OscarMurillol/Digital-1.2-2026-1/DivisionBin.jpg

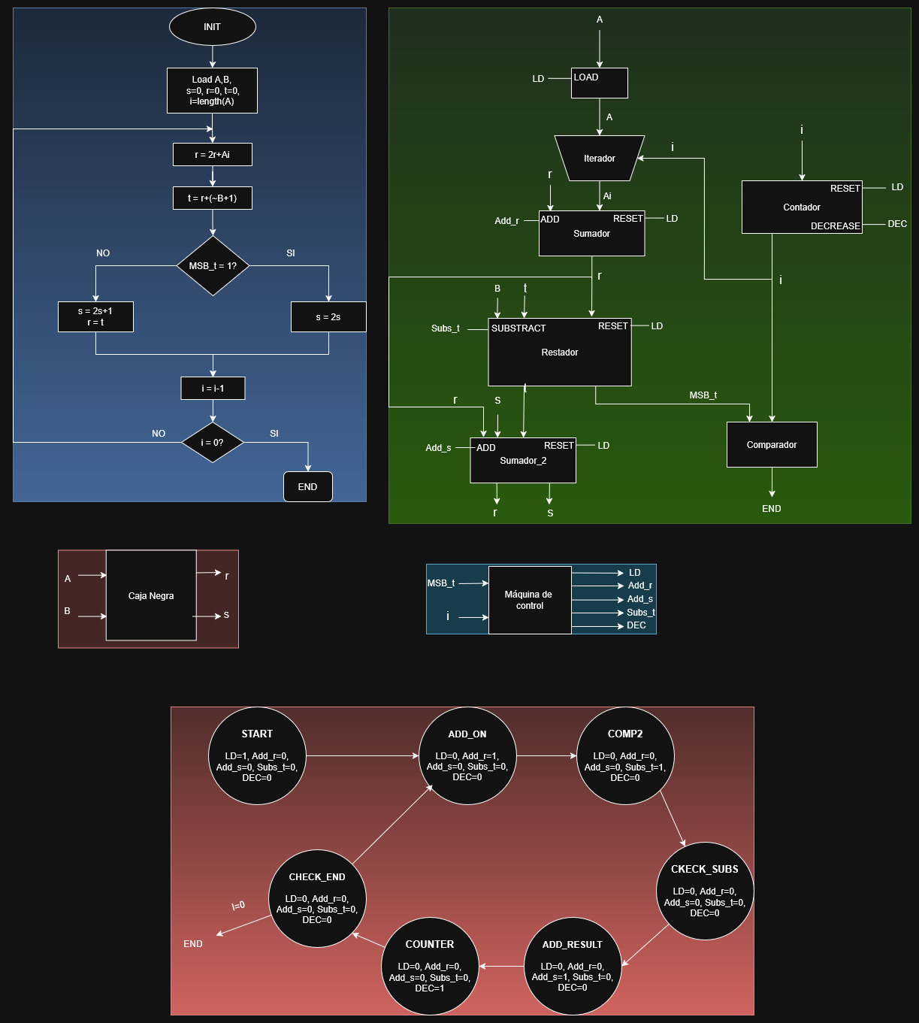
DivisionBin.jpg
