OscarMurillol/Digital-1.2-2026-1/Los Diagramas/DivisionBinCORREGIDO(1).jpg

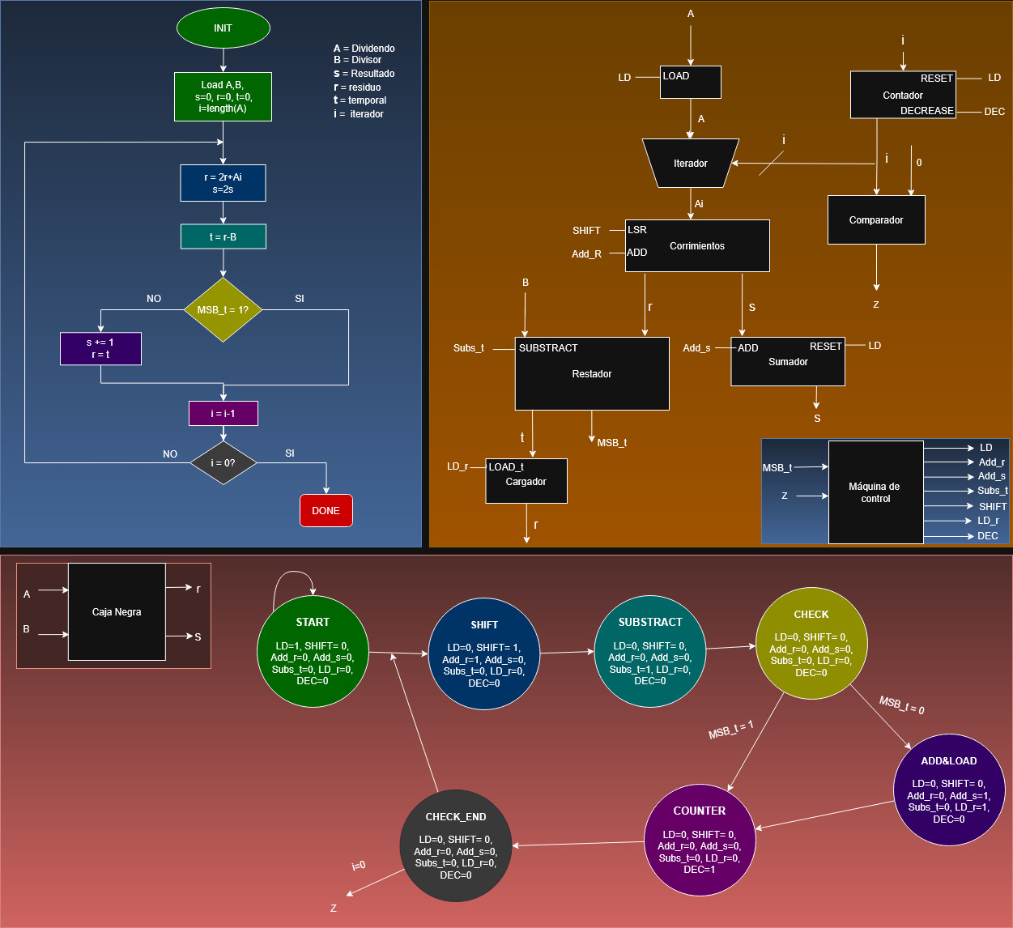
Los Diagramas/DivisionBinCORREGIDO(1).jpg
