OscarMurillol/Digital-1.2-2026-1/CaballodeTroyaEuler/DiagramaGeneral/DiagramaCABALLO.png

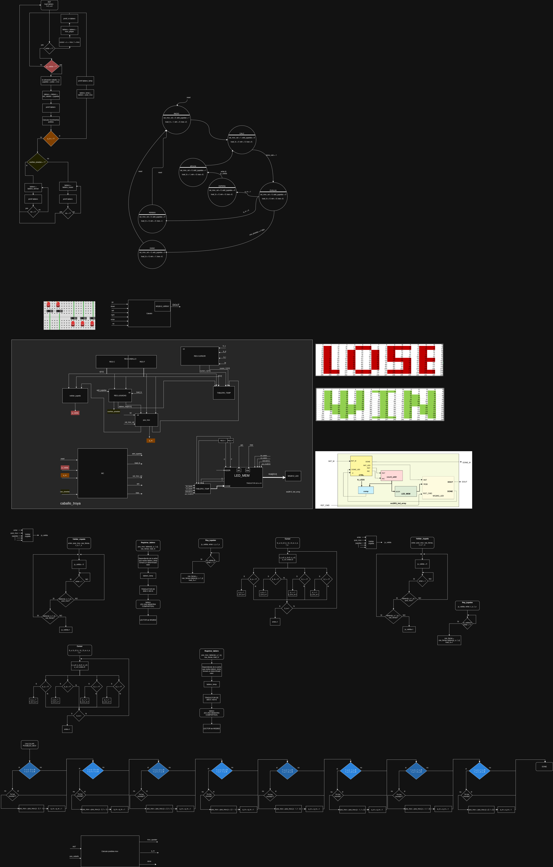
CaballodeTroyaEuler/DiagramaGeneral/DiagramaCABALLO.png
