OscarMurillol/Digital-1.2-2026-1/DFMultBin.jpeg

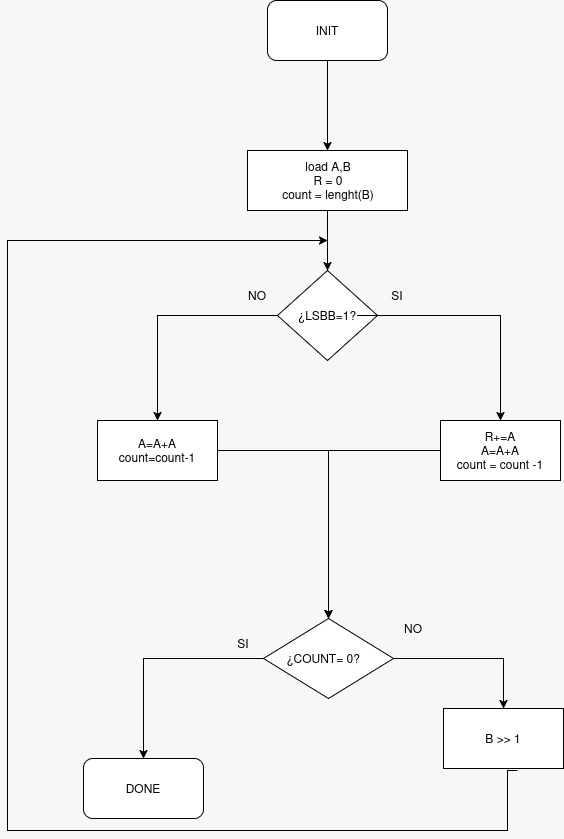
DFMultBin.jpeg
