OscarMurillol/Digital-1.2-2026-1/Los Diagramas/BCDtoBIN.jpg

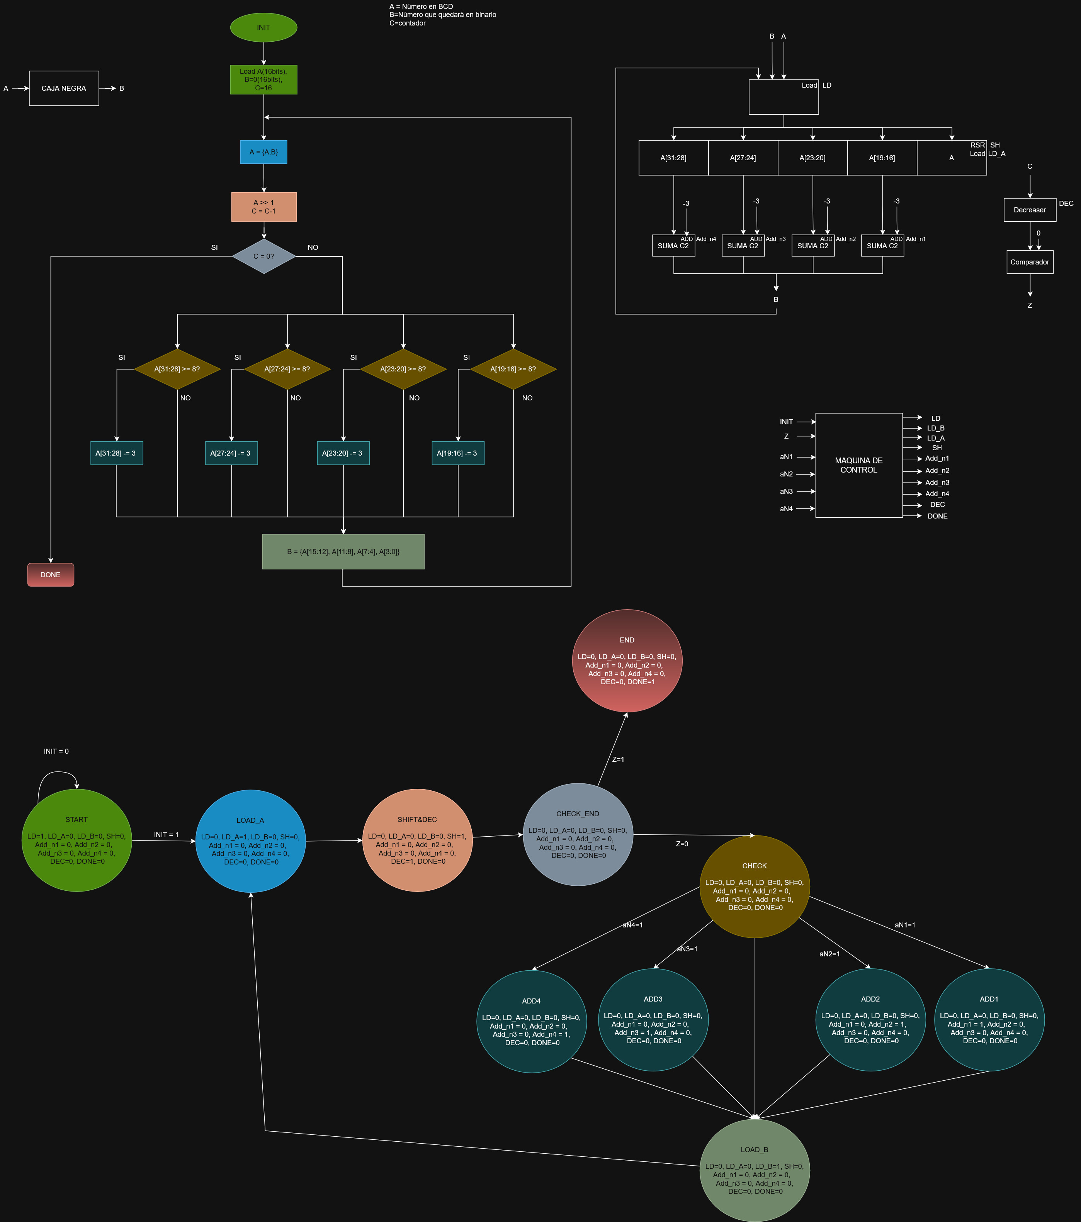
Los Diagramas/BCDtoBIN.jpg
