OscarMurillol/Digital-1.2-2026-1/Los Diagramas/LA MULTIPICASAO(1).jpg

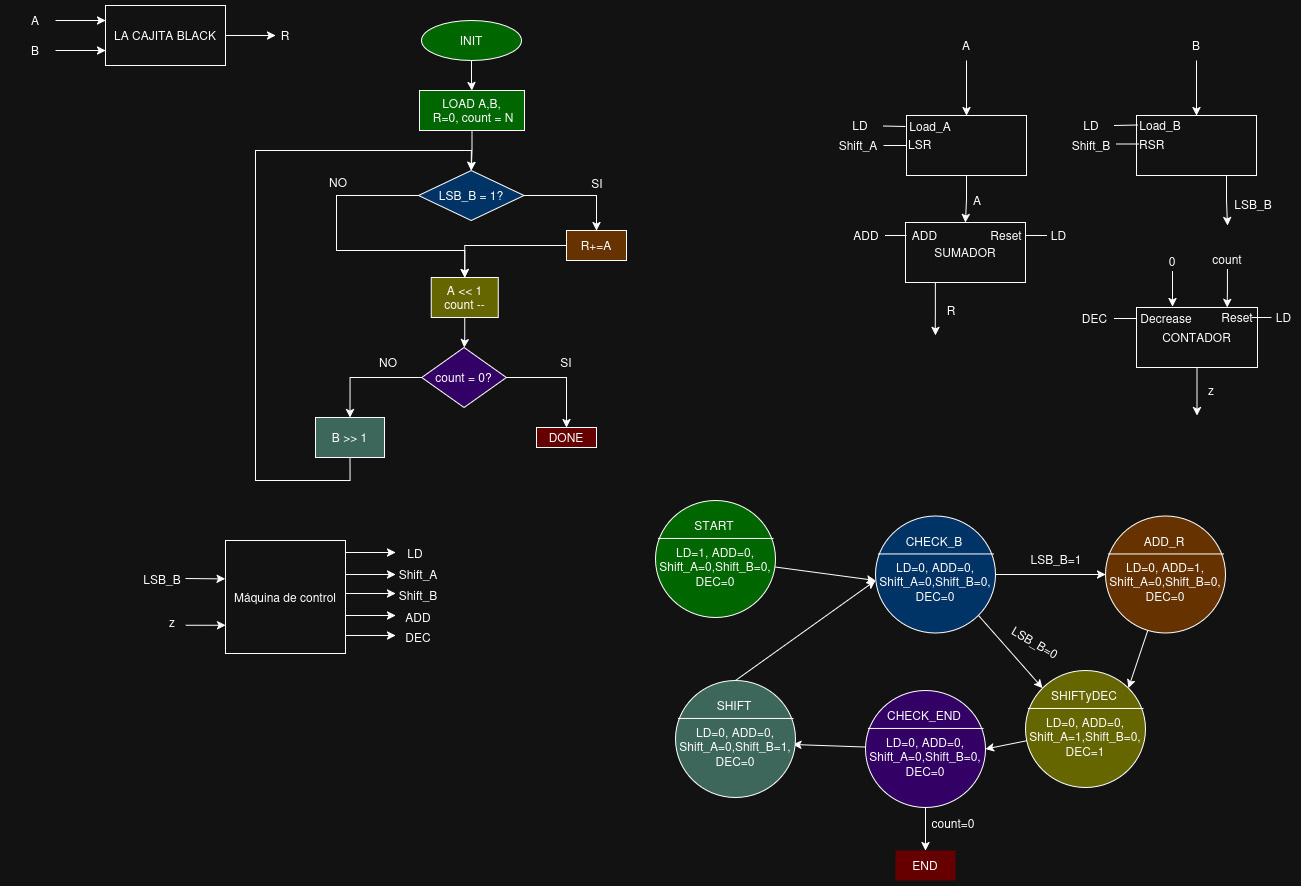
Los Diagramas/LA MULTIPICASAO(1).jpg
