OscarMurillol/Digital-1.2-2026-1/Los Diagramas/SQRT(1).jpg

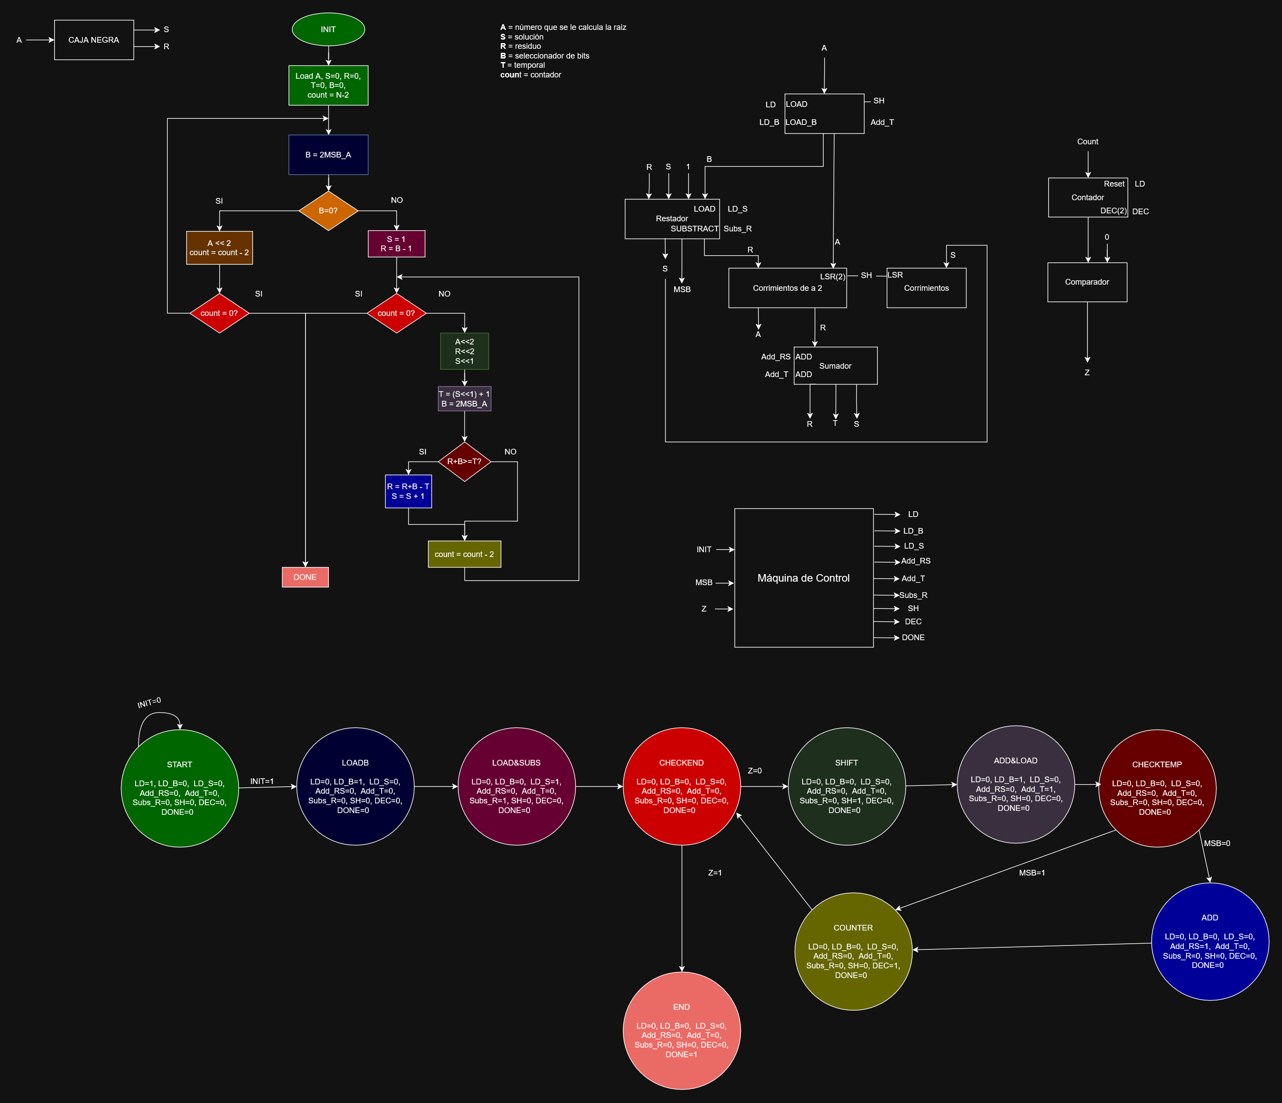
Los Diagramas/SQRT(1).jpg
