OscarMurillol/Digital-1.2-2026-1/Los Diagramas/UART.jpg

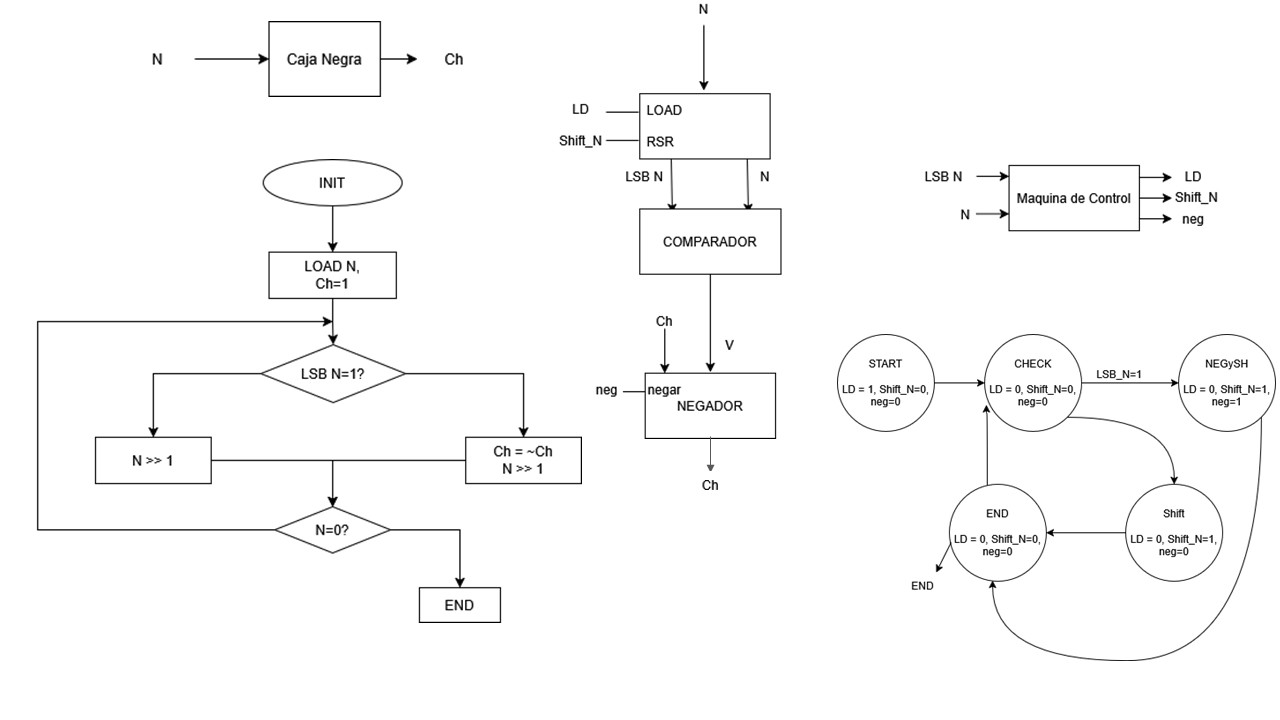
Los Diagramas/UART.jpg
