OscarMurillol/Digital-1.2-2026-1/CaballodeTroyaEuler/DiagramaGeneral/Diagramas.drawio.pdf

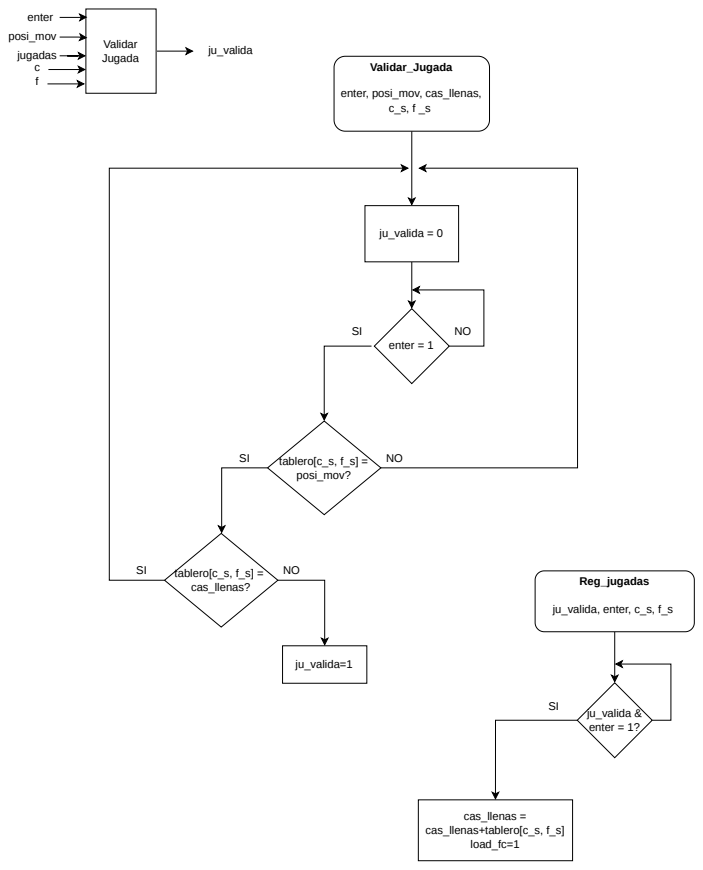
[picture p9: page 1]
Validar_Jugada; enter, posi_mov, cas_llenas, c_s, f _s; ju_valida = 0; enter = 1; ju_valida=1; tablero[c_s, f_s] = posi_mov?; tablero[c_s, f_s] = cas_llenas?; Validar Jugada; enter; posi_mov jugadas c f; ju_valida; Reg_jugadas; ju_valida, enter, c_s, f_s; cas_llenas = cas_llenas+tablero[c_s, f_s] load_fc=1; ju_valida & enter = 1?

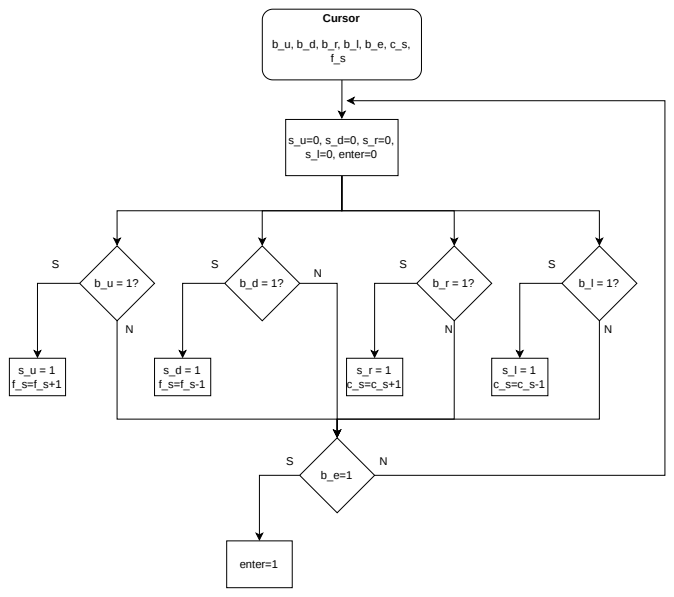
[picture p10: page 2]
Cursor; s_u=0, s_d=0, s_r=0, s_l=0, enter=0; enter=1

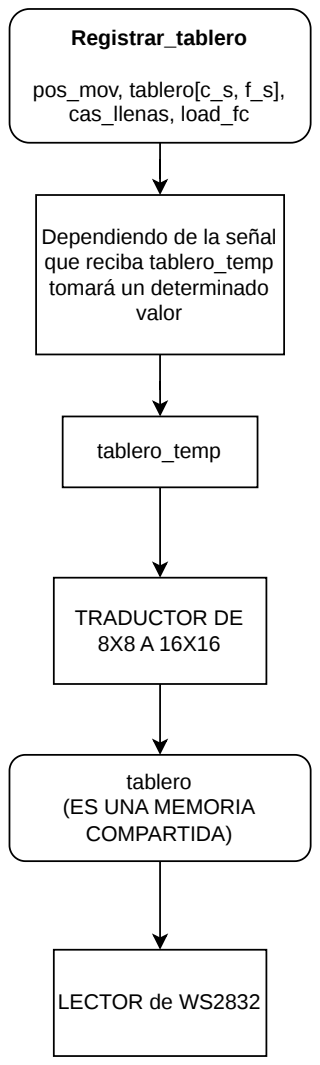
[picture p11: page 3]
Registrar_tablero; pos_mov, tablero[c_s, f_s], cas_llenas, load_fc; valor; tablero_temp; TRADUCTOR DE 8X8 A 16X16; LECTOR de WS2832

Dependiendo de la señal
que reciba tablero_temp
tomará un determinado

tablero
(ES UNA MEMORIA
COMPARTIDA)
