OscarMurillol/Digital-1.2-2026-1/(commit log)

2026-02-19 Add files via upload
    Contiene diagrama de flujo, caja negra, máquina de control, maquina de estados
2026-02-19 Delete UART.png
    me falto una cosita
2026-02-19 Add files via upload
    Contiene: Diagrama de flujo, maquina de control. diagrama de caja negra, maquina de estados
